TradsKraken/Blind-Assist/(commit log)

2026-08-14 feat: implement complete navigation logic, audio track mapping, and sensor integration for Blind Assist system
2026-08-15 feat: upgrade to 65-state navigation logic, restructure documentation into /docs, and add comprehensive build assembly imagery.
